keremcetinkayaeem-cmd/lora-wsn-environmental-monitoring/README.md

# LoRa Tabanlı Kablosuz Sensör Ağı ile Ortam Değişkeni İzleme

Erciyes Üniversitesi Elektrik-Elektronik Mühendisliği bitirme projesi (Haziran 2026).

2 uç düğüm ve 1 ağ geçidinden oluşan, yıldız topolojili bir LoRa (868 MHz) sensör ağı. Uç düğümler sıcaklık, nem, ışık şiddeti, hava kalitesi (TVOC) ve toprak nemi verilerini toplar; ağ geçidi bu verileri ThingSpeak bulut platformuna aktarır.

> English summary: A star-topology LoRa (868 MHz) wireless sensor network with 2 end nodes and 1 gateway, measuring temperature, humidity, light, TVOC and soil moisture, with cloud monitoring on ThingSpeak. Custom PCBs for both the node and the gateway were designed in Altium Designer and manufactured.

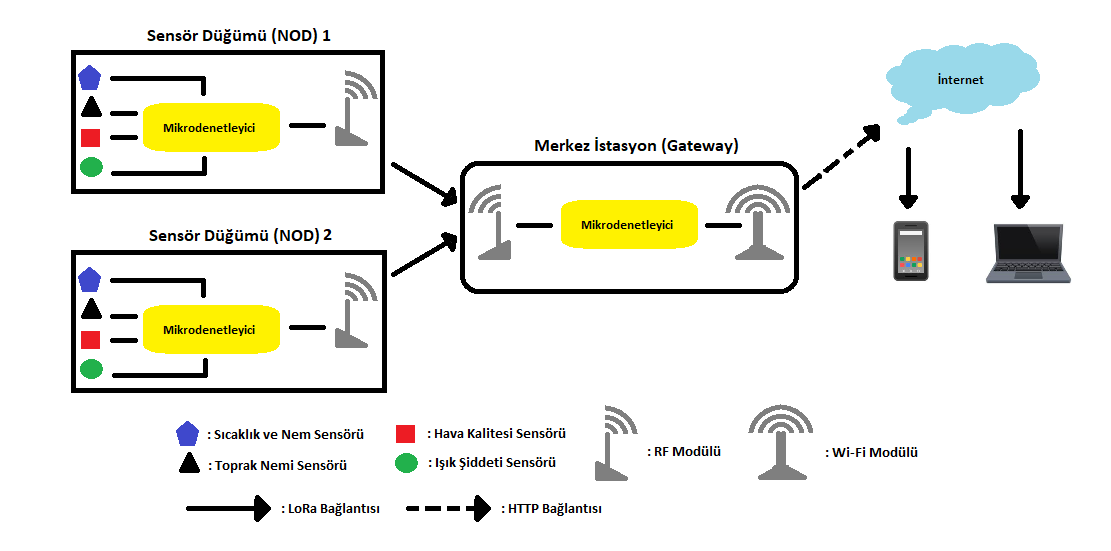
[picture p1: system-diagram.png]
Sistem blok diyagramı


## Öne Çıkanlar

- Uç düğüm ve ağ geçidi için Altium Designer'da şema ve PCB tasarımı (Kerem Çetinkaya), üretilmiş kartlar
- EBYTE E22-900T22D LoRa modülü ile 1,38 km saha testi, paket kaybı olmadan
- Tek telli dijital, I2C ve analog sensör entegrasyonu, özel veri paketi formatı
- ThingSpeak ile gerçek zamanlı izleme
- MATLAB ile SF7-SF12 kapsama ve veri hızı simülasyonu
- 3D yazıcı ile üretilmiş koruyucu kutular

## Sistem Mimarisi

| Katman | Bileşenler |
|---|---|
| Uç düğüm | Arduino Nano, DHT11, BH1750, SGP30, FC-28, EBYTE E22-900T22D, 2 x 18650 pil |
| Ağ geçidi | Arduino Uno R3, EBYTE E22-900T22D, ESP-01 (ESP8266) Wi-Fi modülü, LM2596 ve AMS1117 regülatörler, 2 x 18650 pil |
| Bulut | ThingSpeak |

**Veri paketi formatı:** `<DüğümID,Sıcaklık,Nem,ToprakNemi,TVOC,Işık>`

Örnek: `<1,24.5,45.0,35.0,48,1200>`

## Gerçek Donanım

| Uç düğüm | Ağ geçidi |
|---|---|
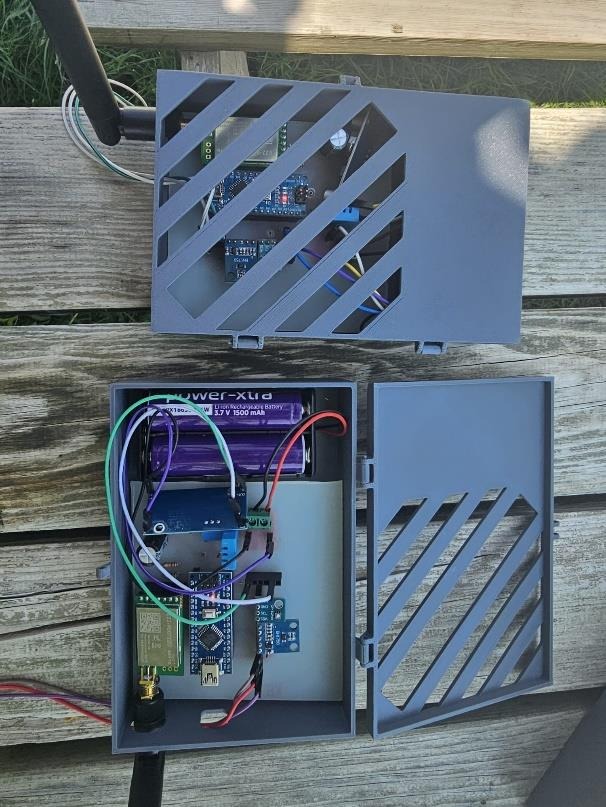
[picture p2: node-real.jpg]
Uç düğüm
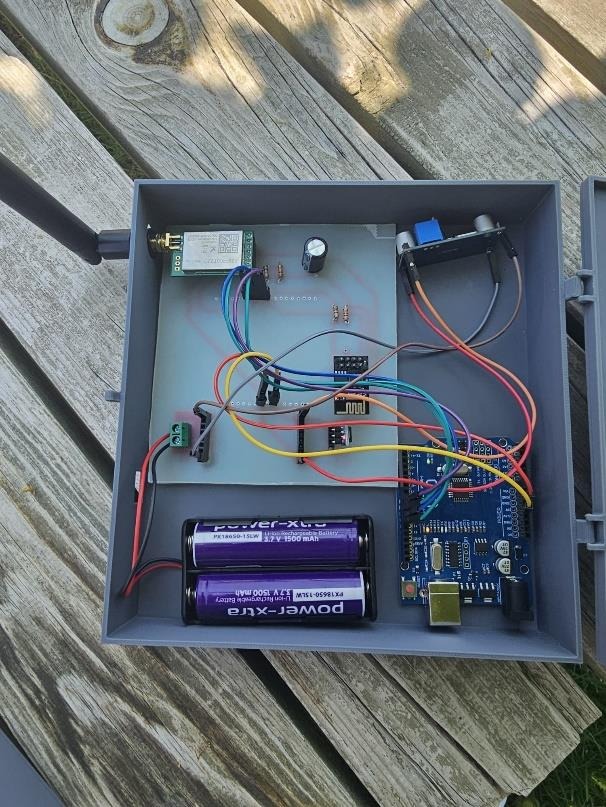
[picture p3: gateway-real.jpg]
Ağ geçidi
|  |  |

## PCB Tasarımı (Altium Designer)

Prototip önce breadboard üzerinde doğrulandı, ardından şema ve PCB tasarımı yapılıp kartlar üretildi.

| Uç düğüm PCB | Ağ geçidi PCB (Arduino Uno shield) |
|---|---|
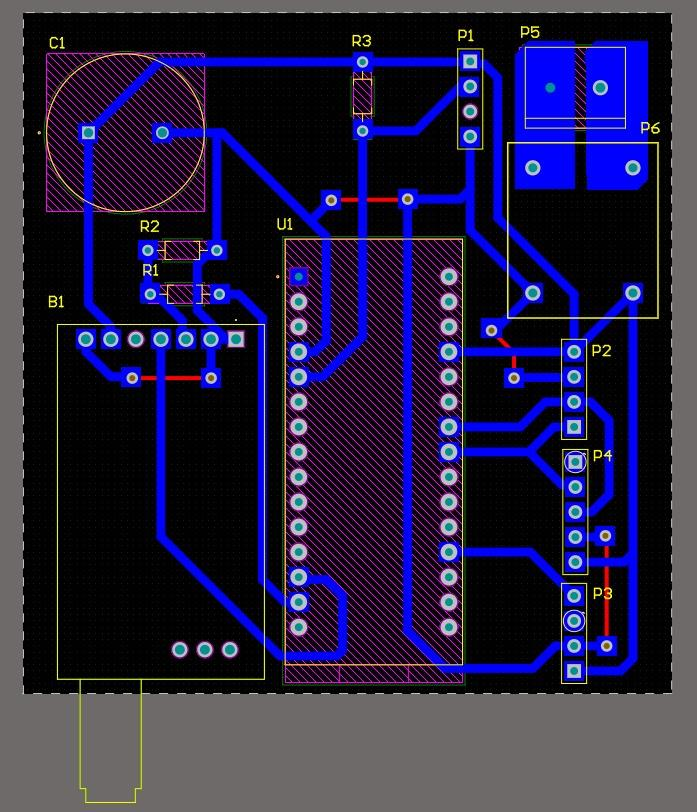
[picture p4: node-pcb.png]
Uç düğüm PCB
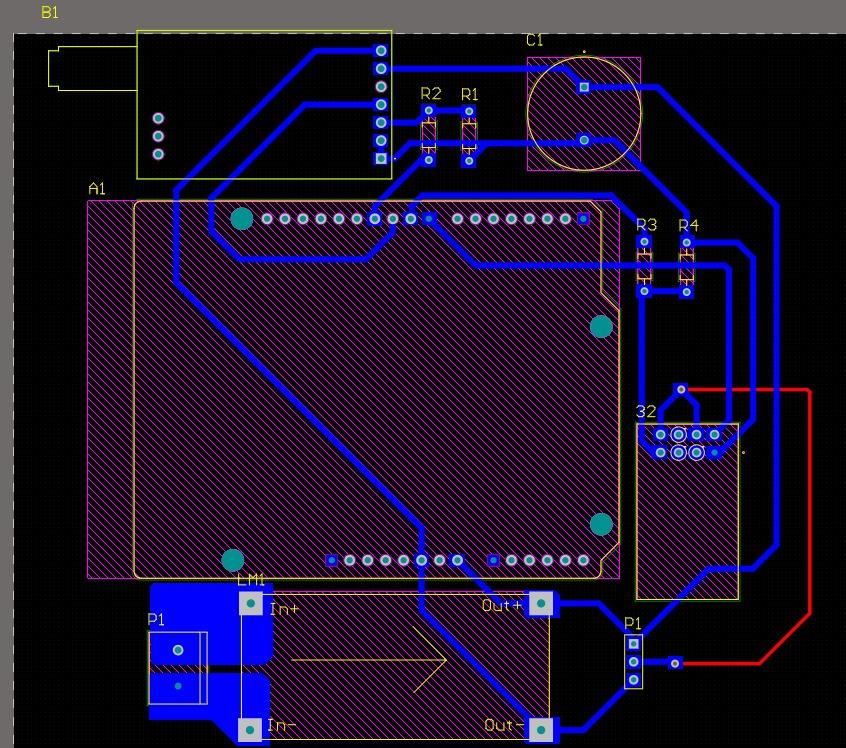
[picture p5: gateway-pcb.png]
Ağ geçidi PCB
|  |  |

| Uç düğüm şeması | Ağ geçidi şeması |
|---|---|
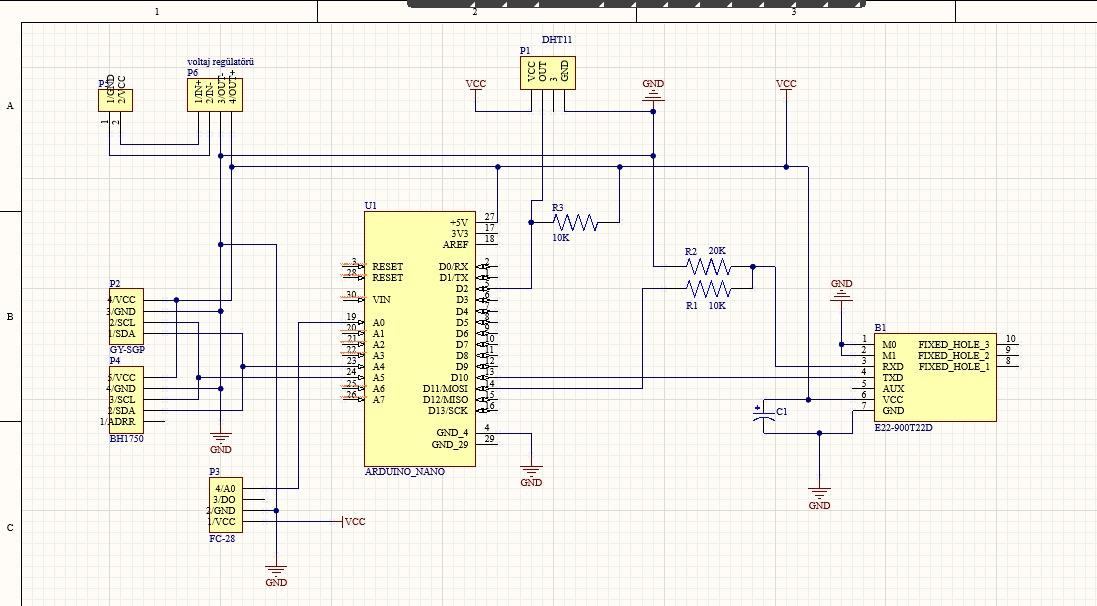
[picture p6: node-schematic.png]
Uç düğüm şeması
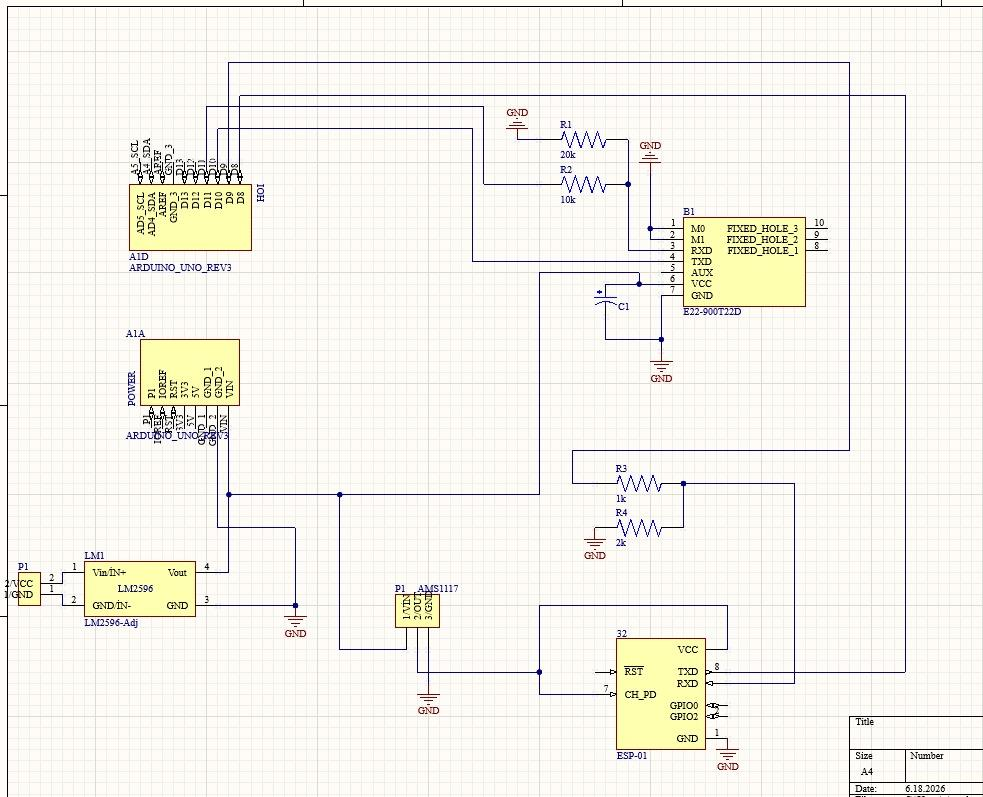
[picture p7: gateway-schematic.png]
Ağ geçidi şeması
|  |  |

**Öne çıkan tasarım kararları**

- Arduino Nano'nun 5V UART çıkışı ile LoRa modülünün 3.3V toleranslı RX pini arasında gerilim bölücü direnç ağı
- Analog ve dijital sinyal yollarının ayrılması (EMI'yi azaltmak için)
- Güç hatlarının LoRa iletim anındaki akım dalgalanmalarına göre kalınlaştırılması
- Ağ geçidinde LM2596 (5V) ve AMS1117 (3.3V) ile ayrı regülatör ağları, ESP-01'in akım çekişine uygun güç yolları

## Saha Testi

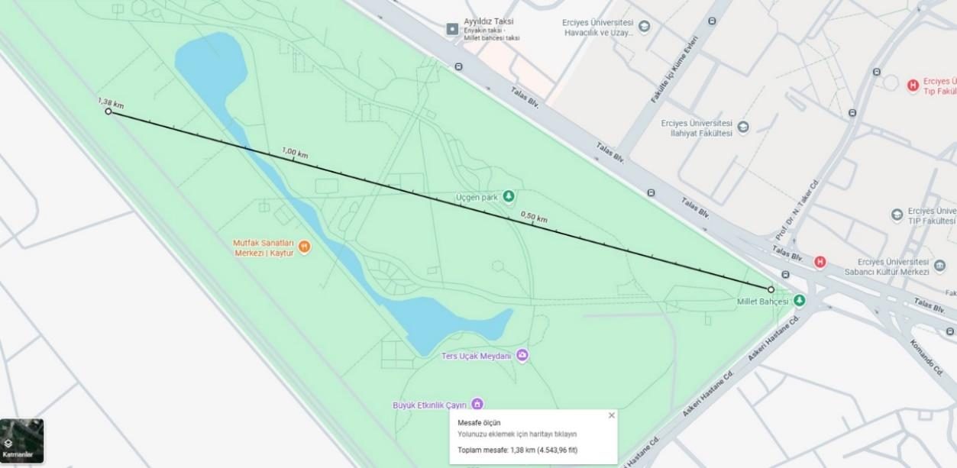
[picture p8: field-test-1.38km.png]
Saha testi


| Parametre | Değer |
|---|---|
| Mesafe | 1,38 km (kuş uçuşu), paket kaybı gözlenmedi |
| Ortam | Kayseri Millet Bahçesi çevresi: ağaçlık alan, su kütleleri, hafif engebe |
| Anten | 868 MHz, 5 dBi SMA |
| Sonuç | Test mesafesinin üst sınırına ulaşılmadı |

## Bulut İzleme (ThingSpeak)

| Düğüm 1 | Düğüm 2 |
|---|---|
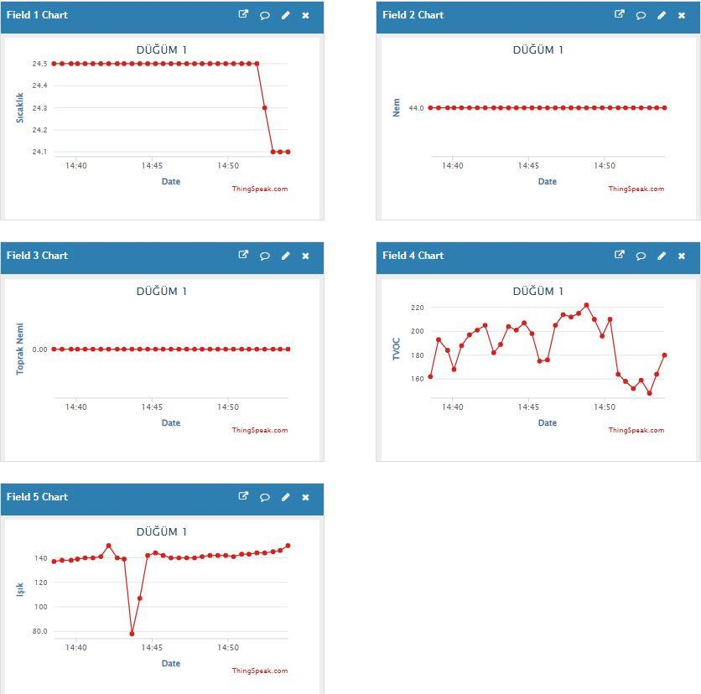
[picture p9: thingspeak-node1.png]
Düğüm 1
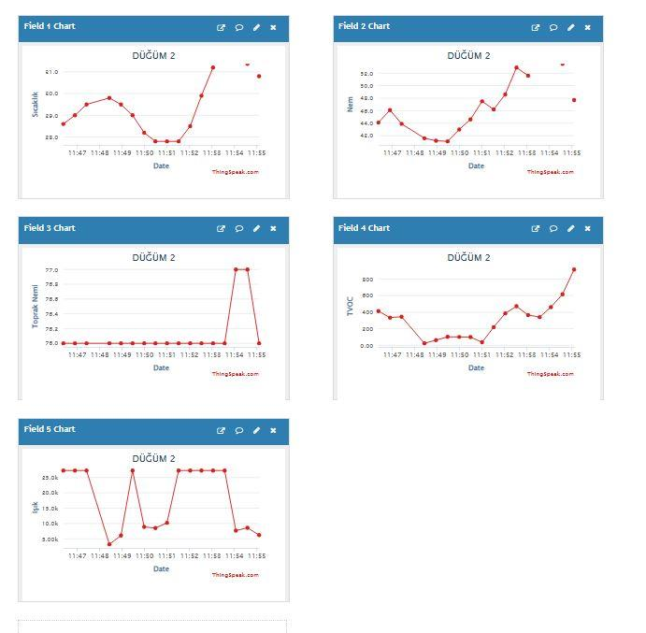
[picture p10: thingspeak-node2.png]
Düğüm 2
|  |  |

## SF7-SF12 Simülasyonu (MATLAB)

Simülasyon, 22 dBm çıkış gücü ve 5 dBi anten kazancı varsayımıyla yapılmıştır. Gerçek ölçüm değildir.

| Kapsama | Veri hızı |
|---|---|
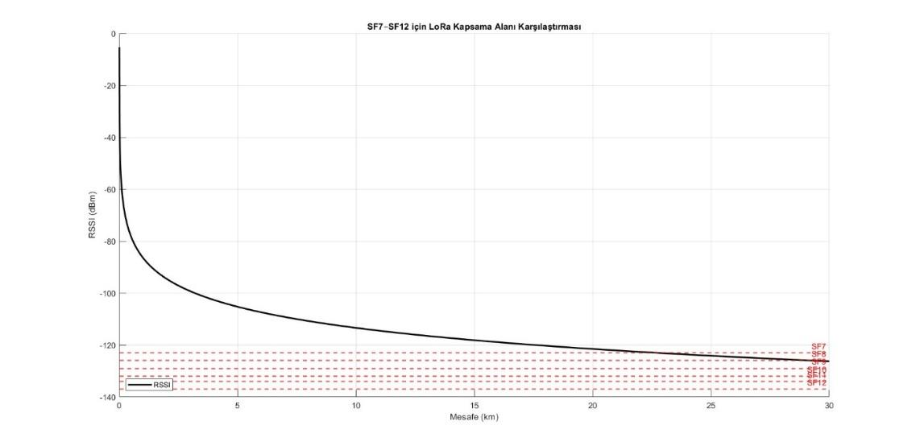
[picture p11: sf-coverage-simulation.png]
Kapsama
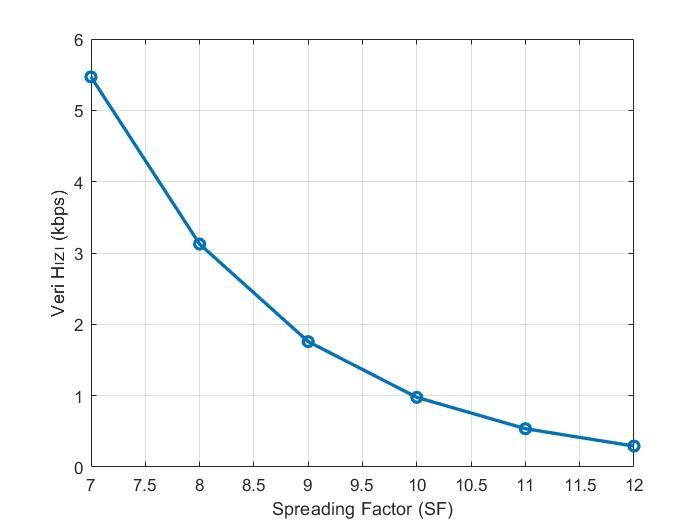
[picture p12: sf-datarate-simulation.png]
Veri hızı
|  |  |

## Kurulum

1. `node.ino` dosyasını Arduino Nano'ya yükle. İkinci düğüm için dosyanın başındaki `NODE_ID` değerini 2 yap.
2. `gateway.ino` dosyasını Arduino Uno'ya yükle. Önce Wi-Fi adı, şifresi ve ThingSpeak kanal yazma anahtarlarını (`API_KEY_BURAYA`) kendi bilgilerinle değiştir.
3. Gerekli Arduino kütüphaneleri: Adafruit SGP30, DHT sensor library, hp_BH1750.

## Proje Ekibi

| İsim
|---|---|
| Kerem Çetinkaya 
| Yusuf Dikici 
| Tümer Demirkol 

Danışman: Prof. Dr. Ömer Galip Saraçoğlu

## Bilinen Sınırlar ve Geliştirme Fikirleri

- Test, 1,38 km ile sınırlı kaldı; maksimum menzil denenmedi.
- Güç tasarrufu için gerçek derin uyku modu eklenebilir.
- Yıldız topoloji yerine mesh yapıya geçilerek kapsama genişletilebilir.
- Arduino Uno + ESP-01 yerine tek bir ESP32 ile ağ geçidi sadeleştirilebilir.

## İletişim

Kerem Çetinkaya · kerem.cetinkayaeem@gmail.com
