keremcetinkayaeem-cmd/lora-wsn-environmental-monitoring/gateway-breadboard.png

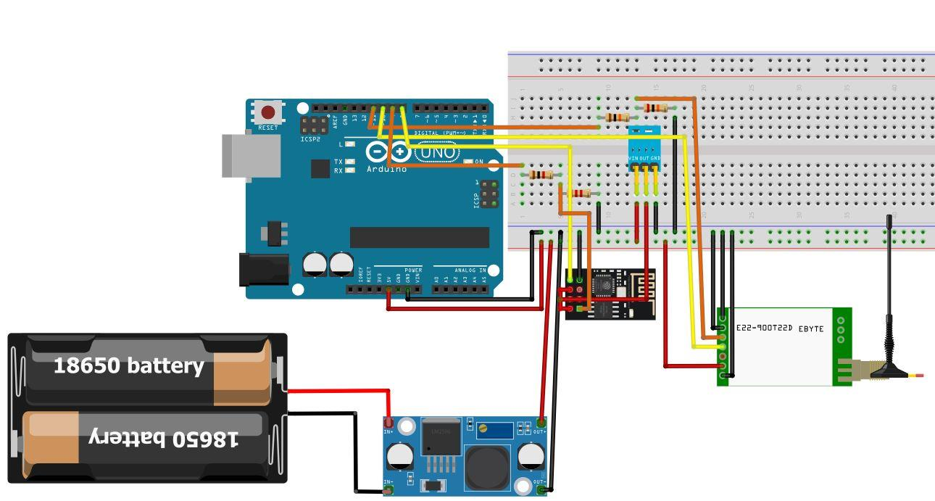
gateway-breadboard.png
