keremcetinkayaeem-cmd/lora-wsn-environmental-monitoring/node-breadboard.png

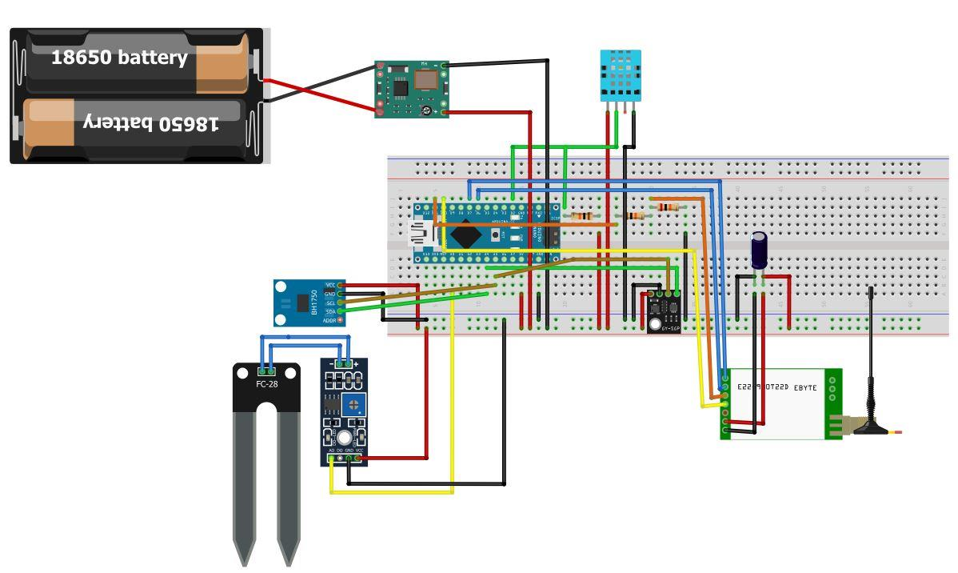
node-breadboard.png
